pozhariskaia-ksu/Trinity/cubesat_faserns_servo2.jpg

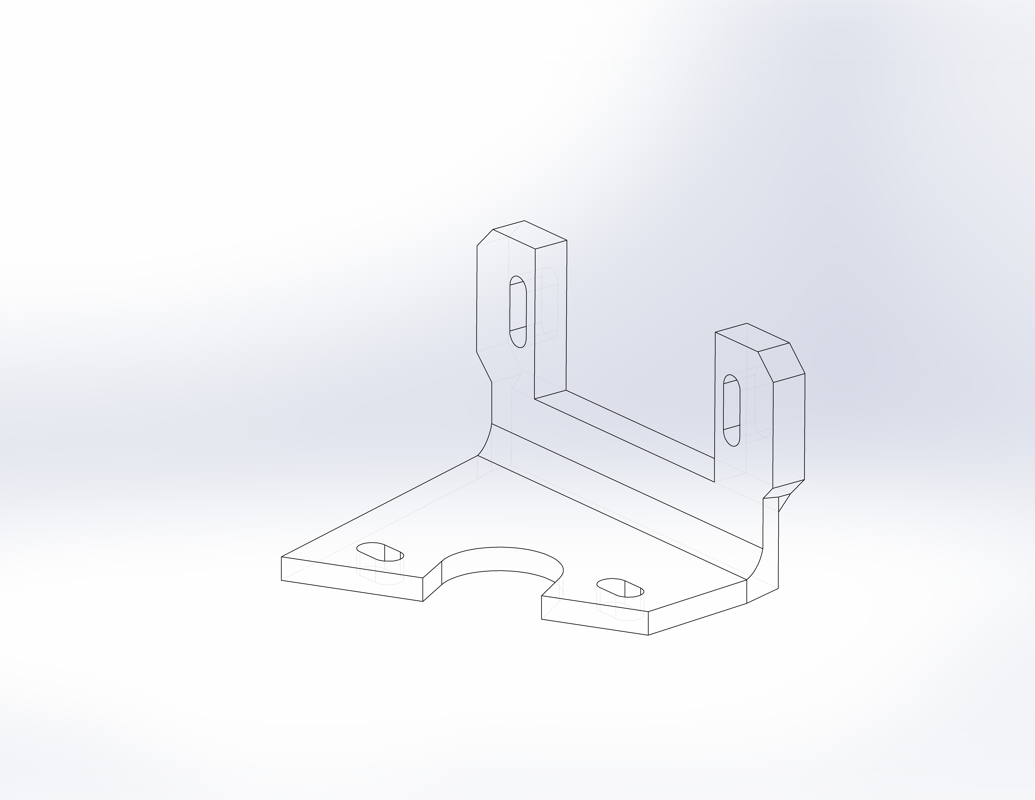
cubesat_faserns_servo2.jpg
