pozhariskaia-ksu/Trinity/Фото/IMAGE 2026-02-09 00:02:16.jpg

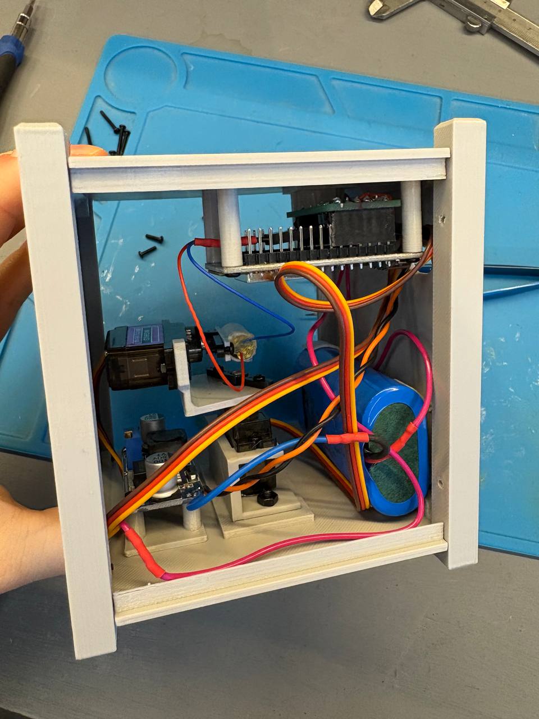
Фото/IMAGE 2026-02-09 00:02:16.jpg
