pozhariskaia-ksu/Trinity/Фото/IMAGE 2026-02-09 00:02:20.jpg

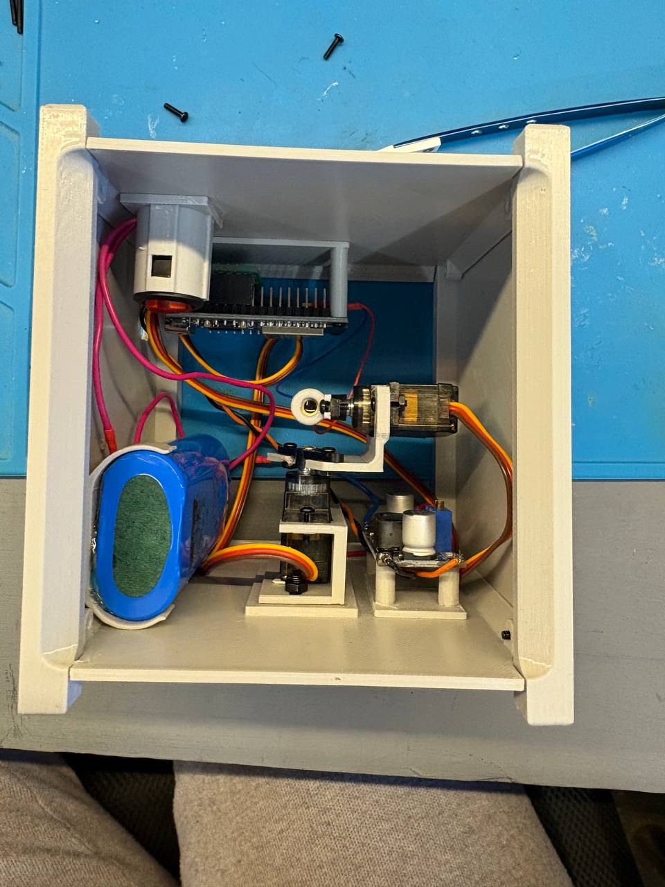
Фото/IMAGE 2026-02-09 00:02:20.jpg
