pozhariskaia-ksu/Trinity/Фото/IMAGE 2026-02-09 00:02:39.jpg

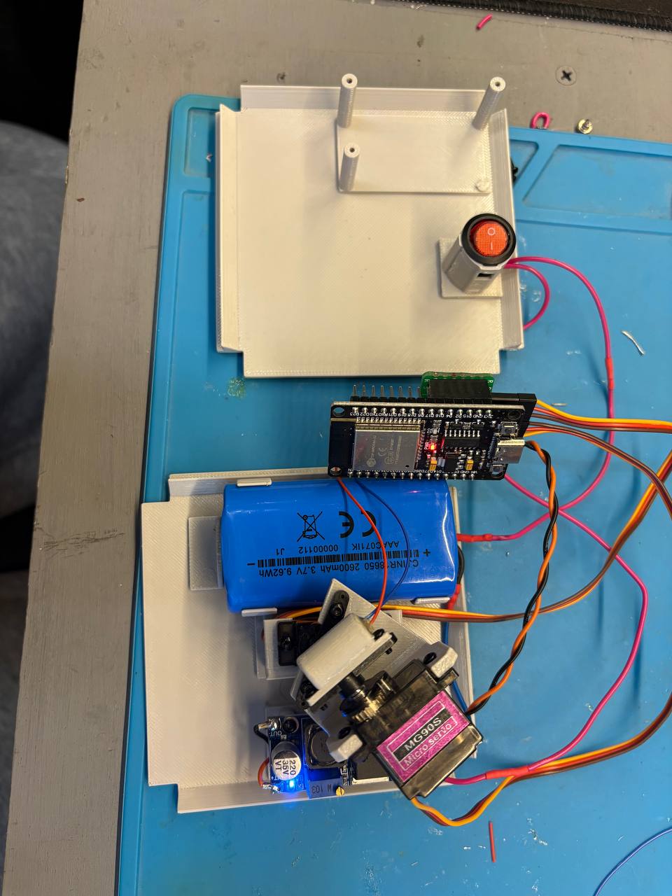
Фото/IMAGE 2026-02-09 00:02:39.jpg
