pozhariskaia-ksu/Trinity/Чертежи/1000079052.jpg

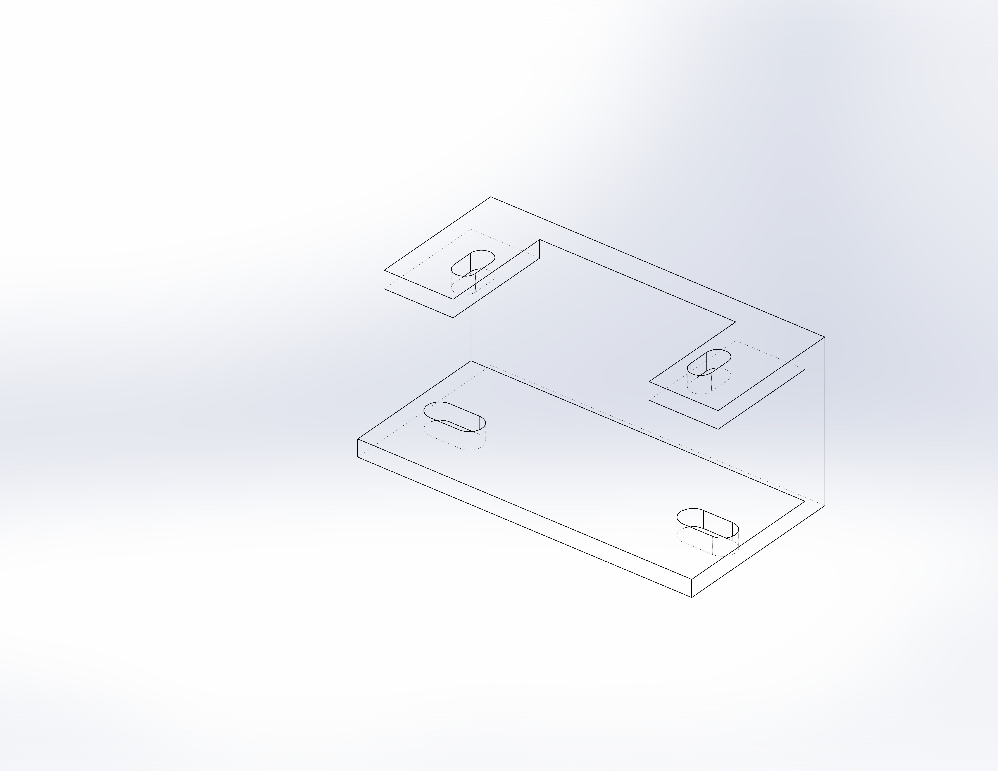
Чертежи/1000079052.jpg
