pozhariskaia-ksu/Trinity/Чертежи/1000079053.jpg

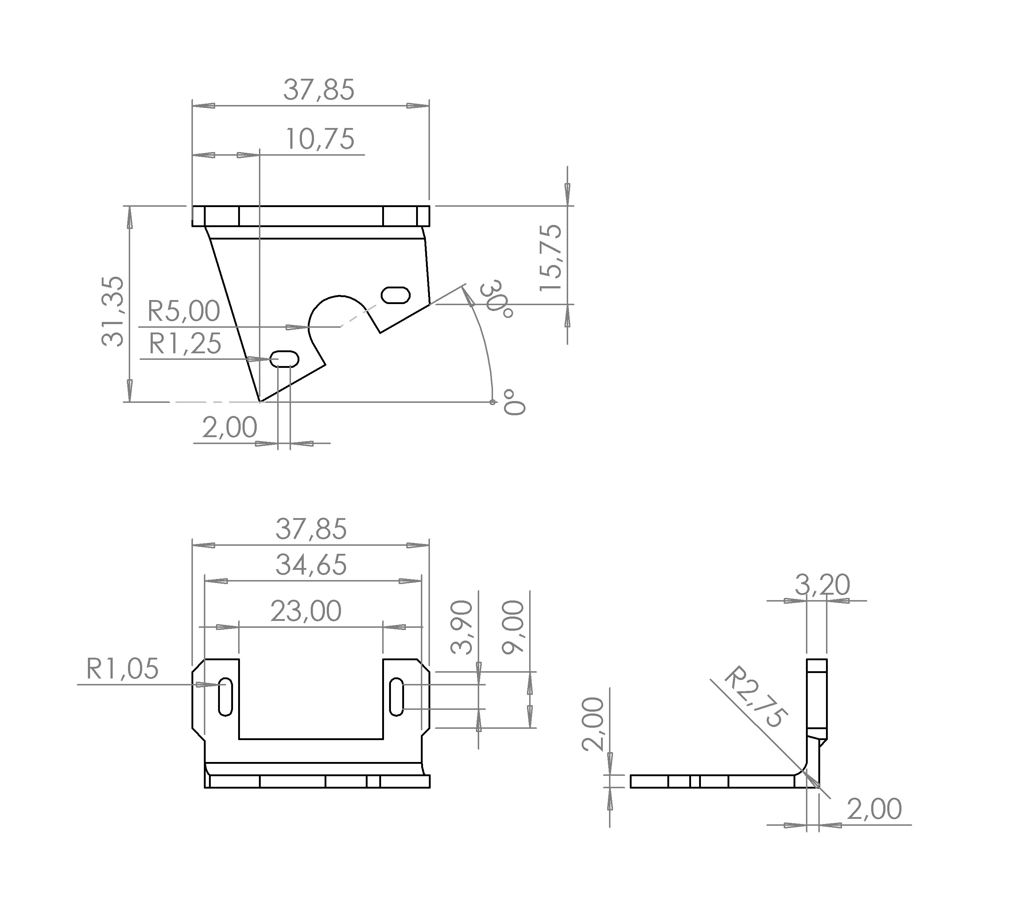
Чертежи/1000079053.jpg
