pozhariskaia-ksu/Trinity/Чертежи/1000079054.jpg

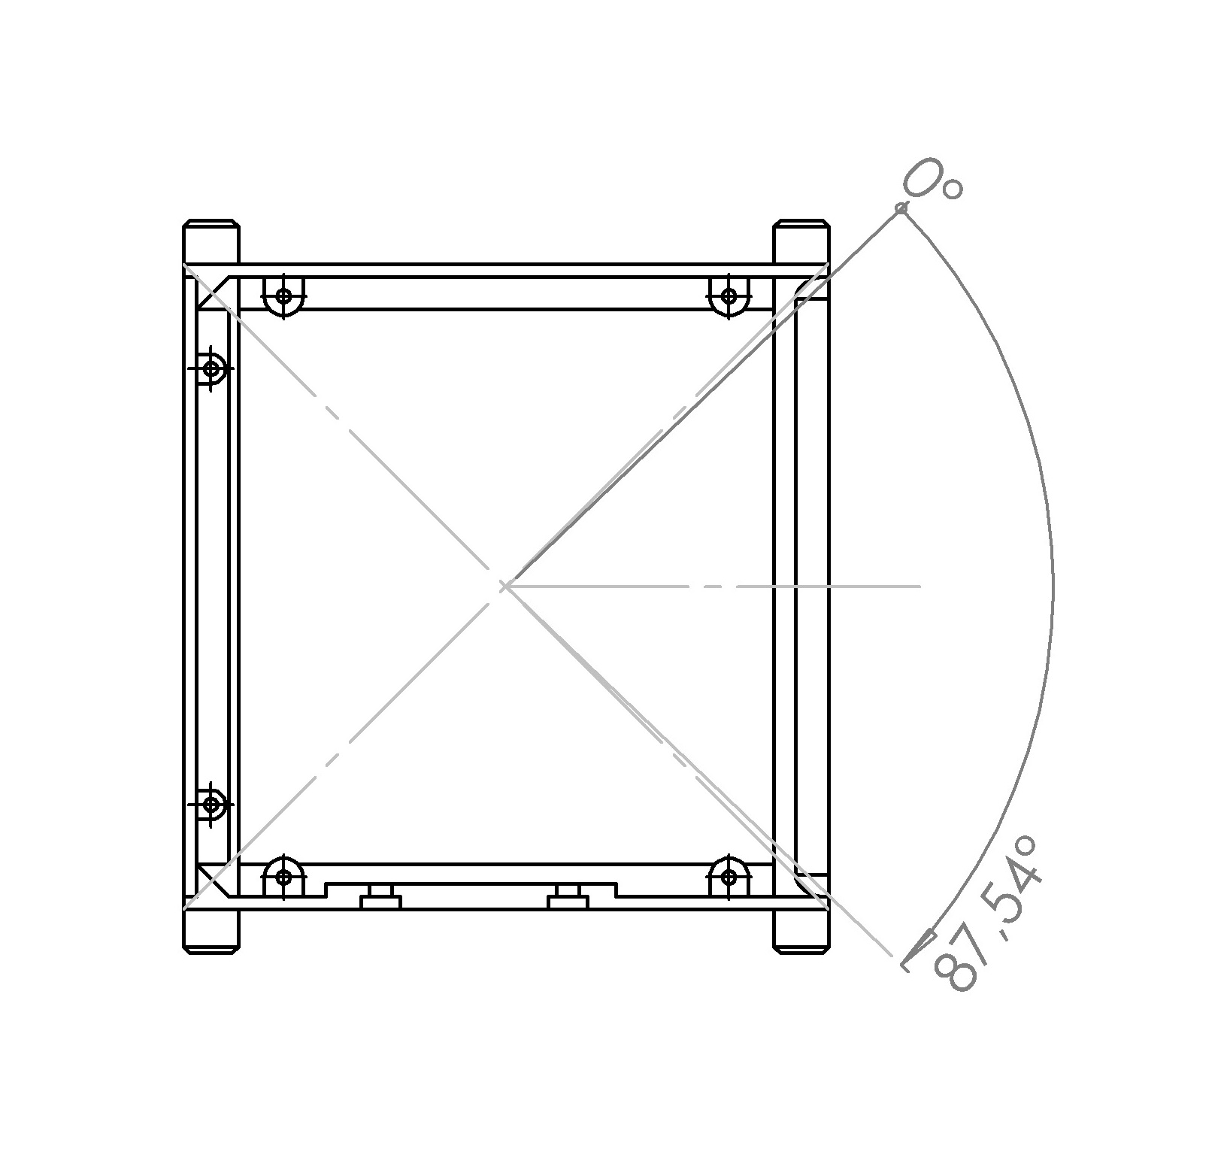
Чертежи/1000079054.jpg
