pozhariskaia-ksu/Trinity/Чертежи/1000079055.jpg

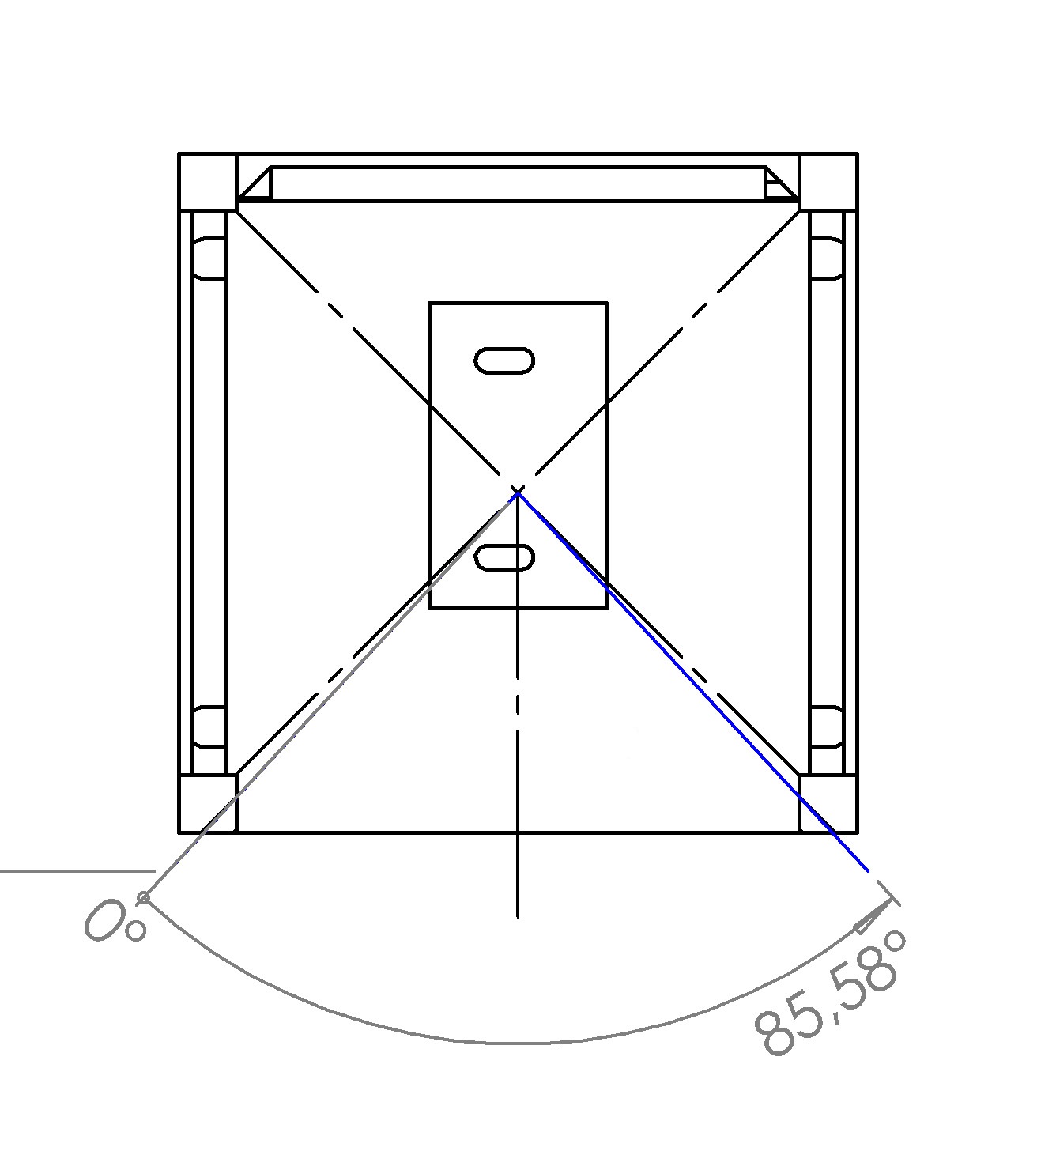
Чертежи/1000079055.jpg
