pozhariskaia-ksu/Trinity/Чертежи/1000079058.jpg

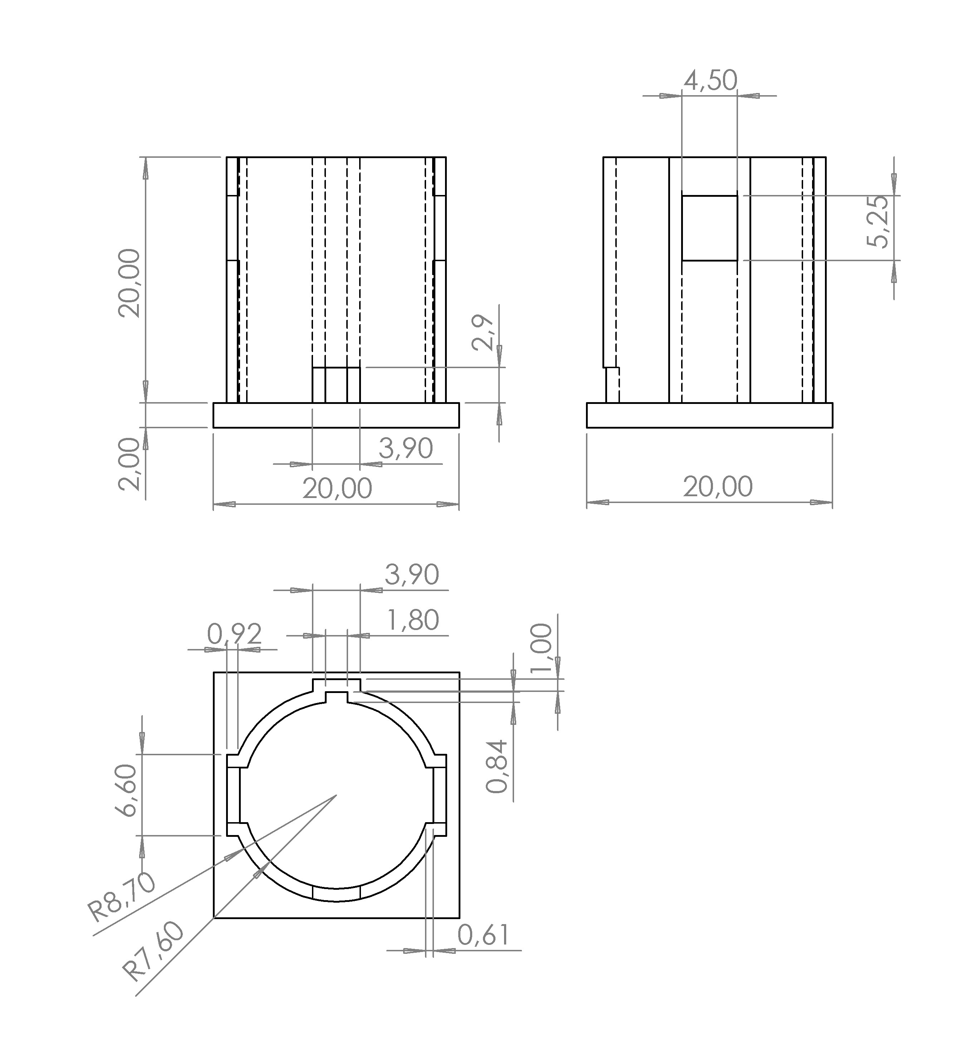
Чертежи/1000079058.jpg
