pozhariskaia-ksu/Trinity/Чертежи/1000079060.jpg

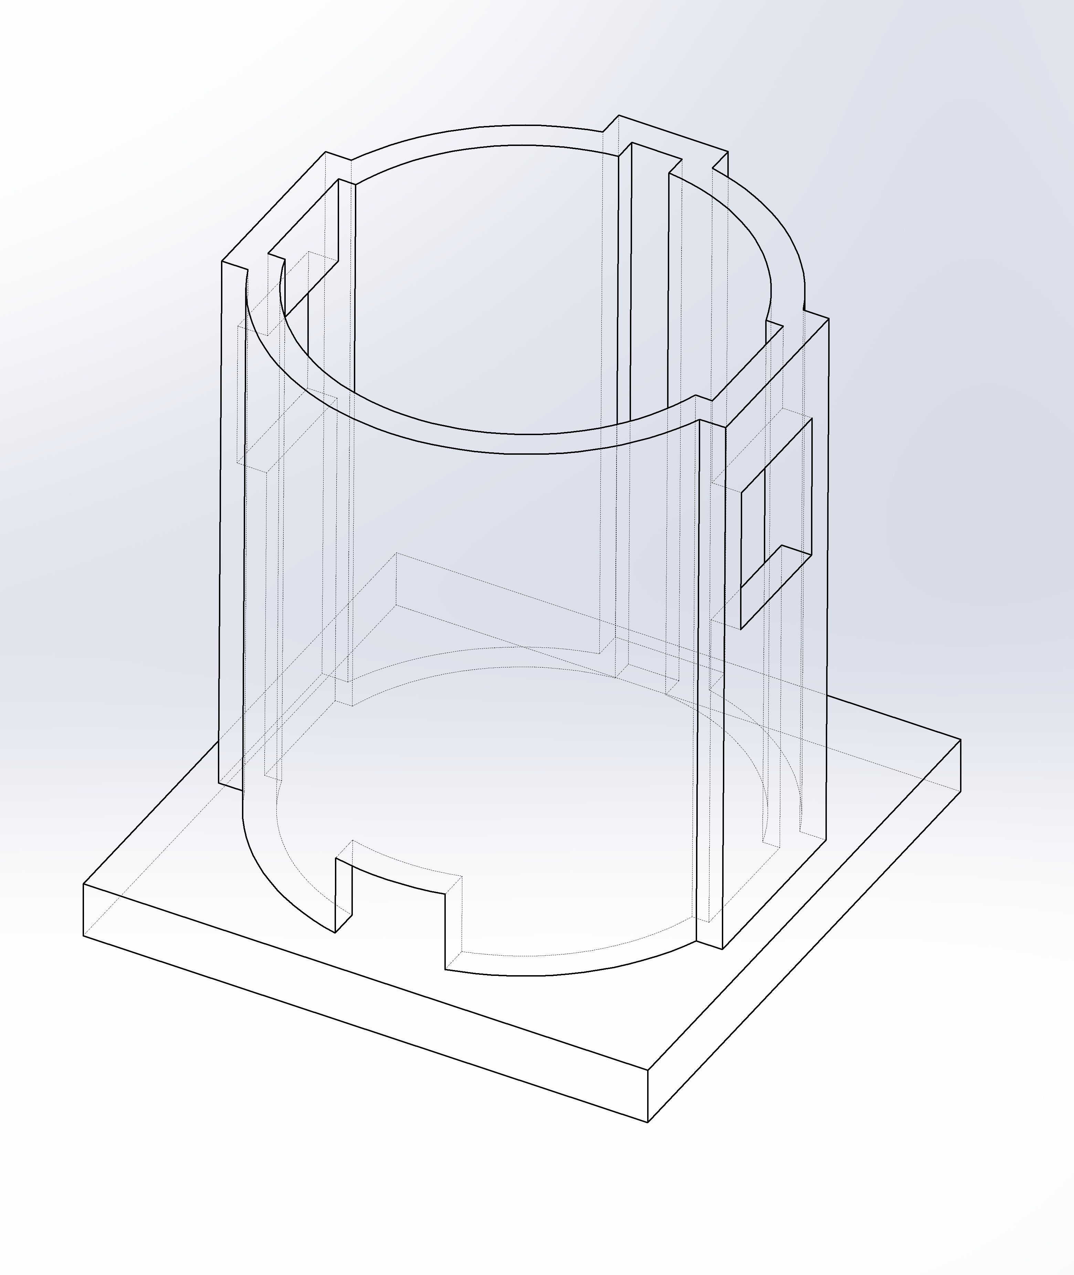
Чертежи/1000079060.jpg
