pozhariskaia-ksu/Trinity/Чертежи/cubesat_fasteners_servo.jpg

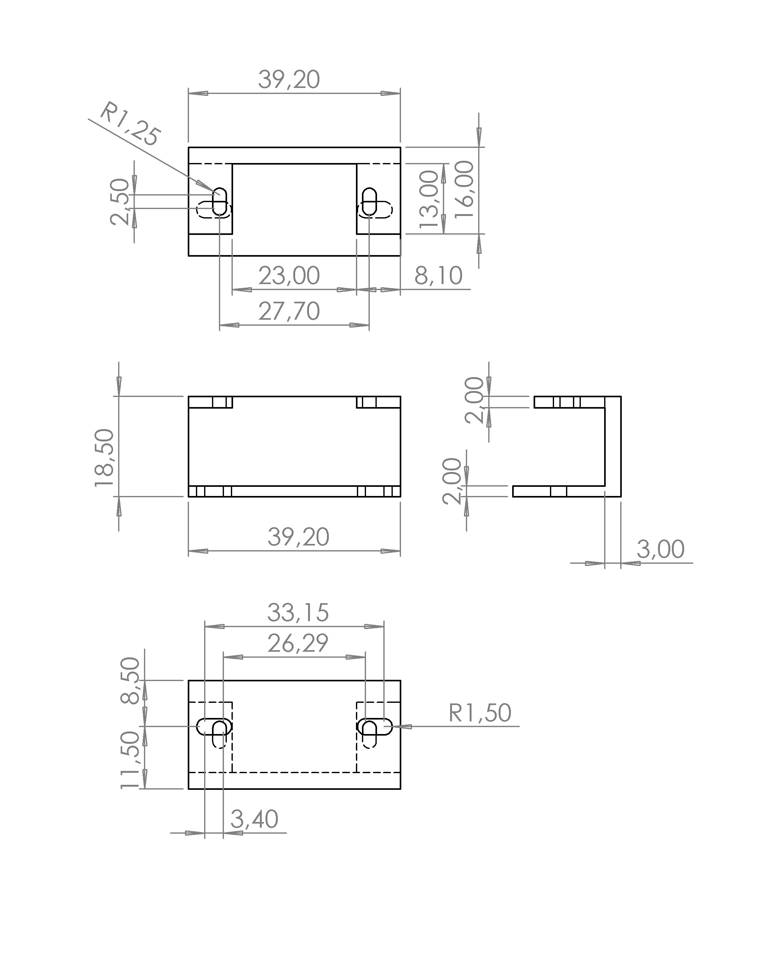
Чертежи/cubesat_fasteners_servo.jpg
