pozhariskaia-ksu/Trinity/Чертежи/В сборе.jpg

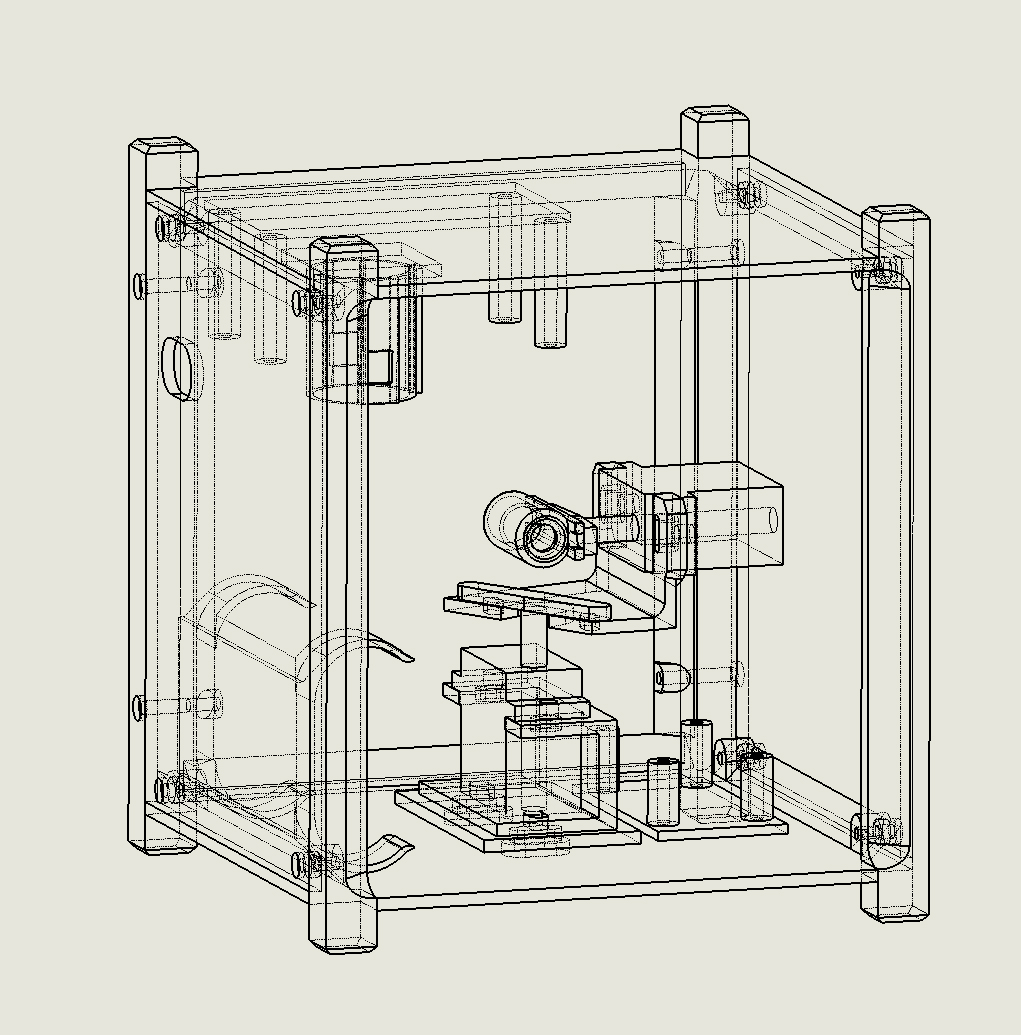
Чертежи/В сборе.jpg
