pozhariskaia-ksu/Trinity/Чертежи/Сборка корпуса 2.JPG

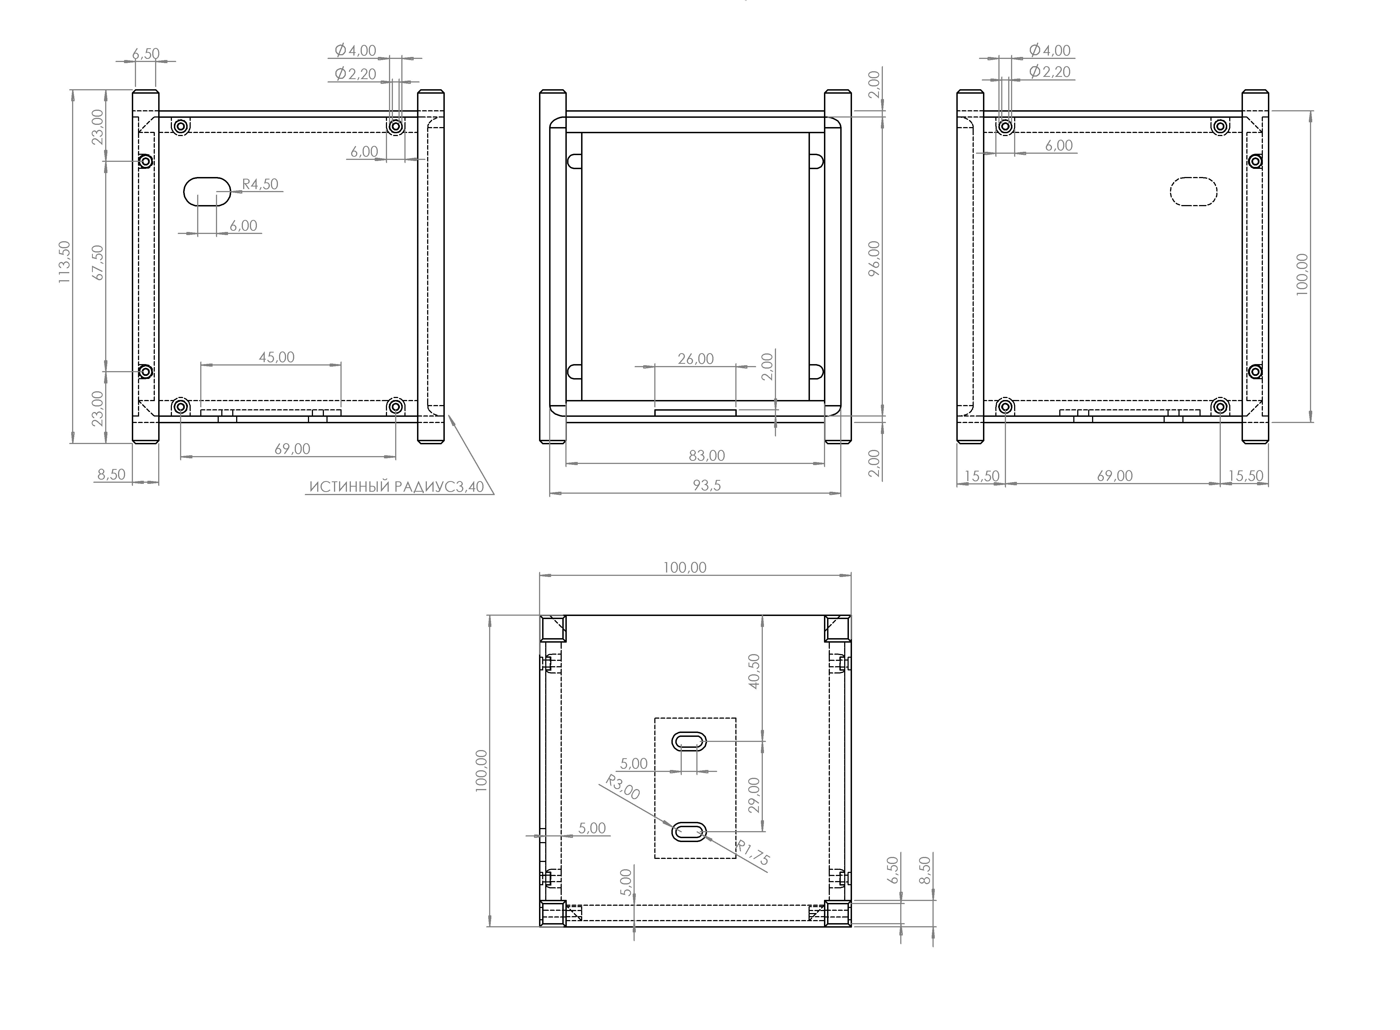
Чертежи/Сборка корпуса 2.JPG
