pozhariskaia-ksu/Trinity/3D модели/Крышка пульта.STL

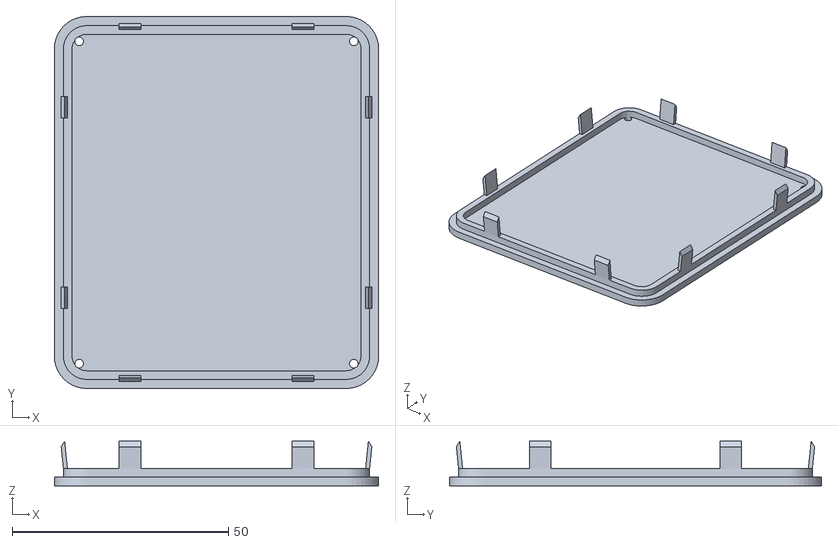
[picture p40: CAD file, 2026-02-08]
3D модели/Крышка пульта.STL
75.0 x 86.0 x 10.3
