pozhariskaia-ksu/Trinity/3D модели/??????? ??????  с отверстием.STL

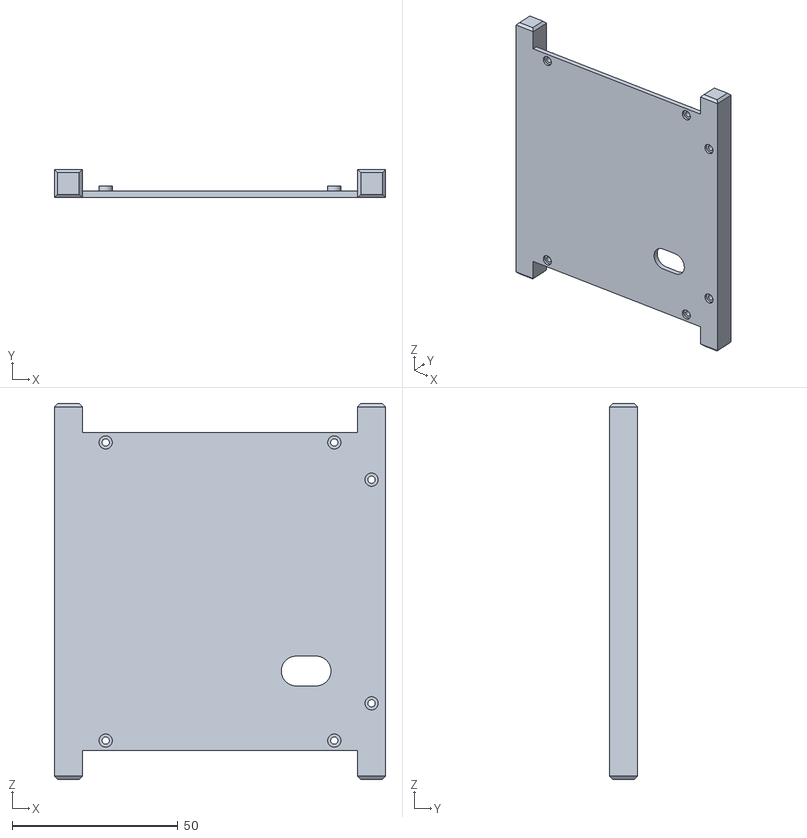
[picture p41: CAD file, 2026-02-08]
3D модели/??????? ?????? с отверстием.STL
100.0 x 8.50 x 113.5
