pozhariskaia-ksu/Trinity/3D модели/Подложка клавиатуры.STL

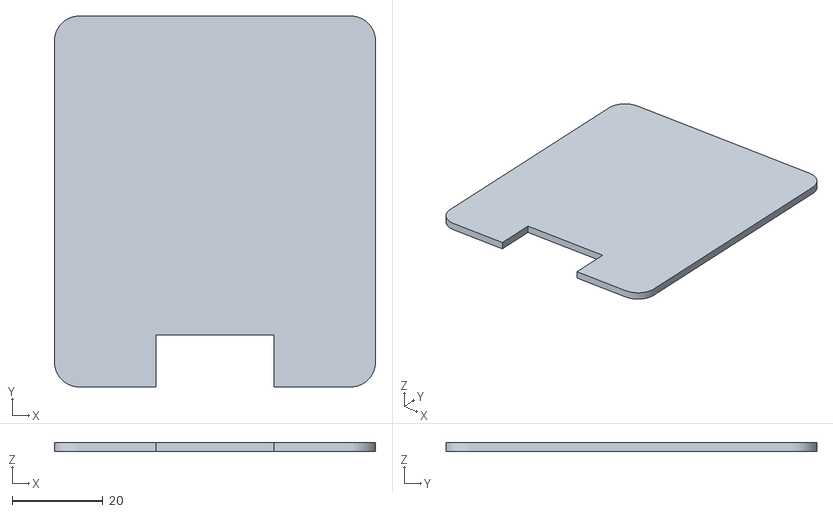
[picture p42: CAD file, 2026-02-08]
3D модели/Подложка клавиатуры.STL
70.9 x 81.9 x 2.00
