pozhariskaia-ksu/Trinity/3D модели/Контейнер 3хАА.STL

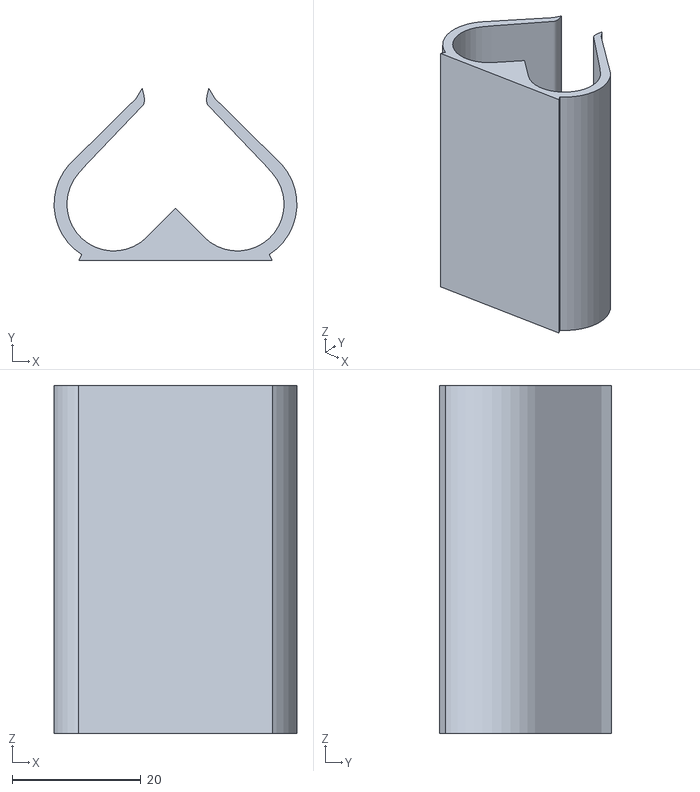
[picture p43: CAD file, 2026-02-08]
3D модели/Контейнер 3хАА.STL
37.7 x 26.7 x 54.0
