pozhariskaia-ksu/Trinity/3D модели/??????? ?????? ния крышки.STL

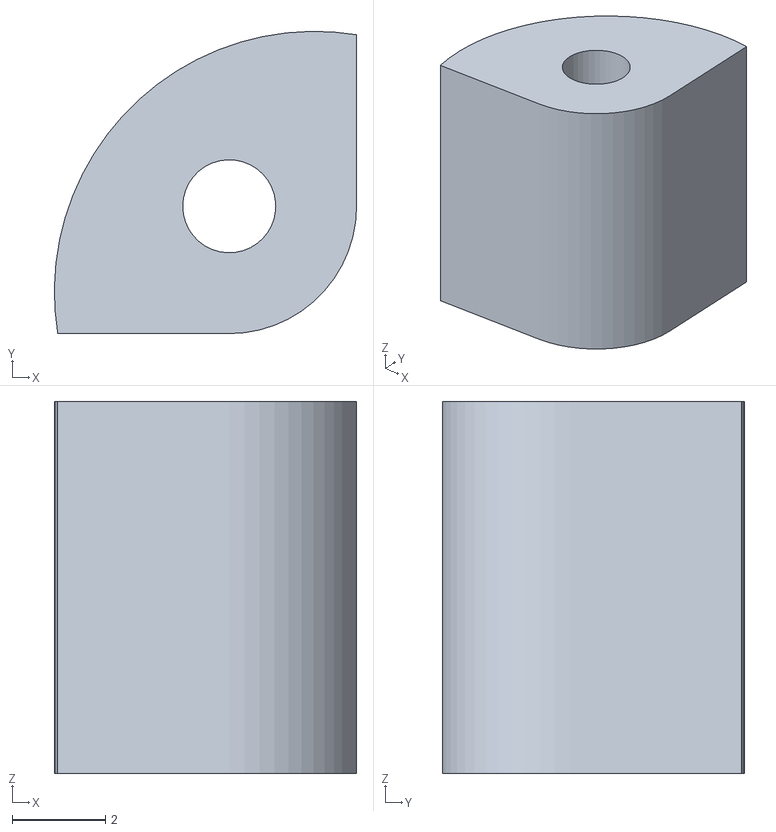
[picture p44: CAD file, 2026-02-08]
3D модели/??????? ?????? ния крышки.STL
6.50 x 6.50 x 8.00
