pozhariskaia-ksu/Trinity/3D модели/????? ????????? ей платы х3.STL

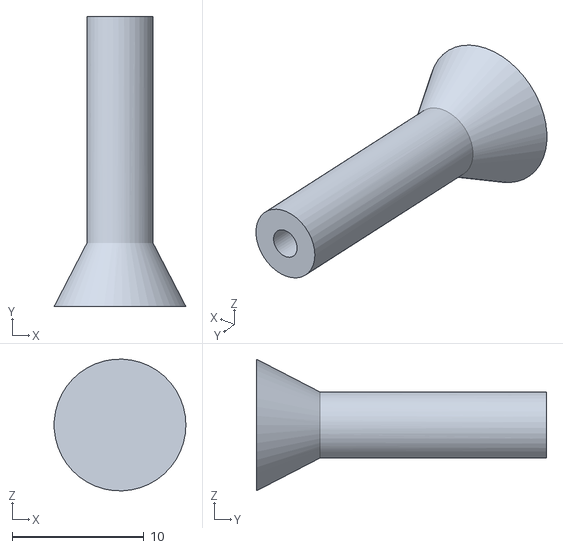
[picture p45: CAD file, 2026-02-08]
3D модели/????? ????????? ей платы х3.STL
10.0 x 22.0 x 9.99
