pozhariskaia-ksu/Trinity/3D модели/Корпус пульта деталь.STL

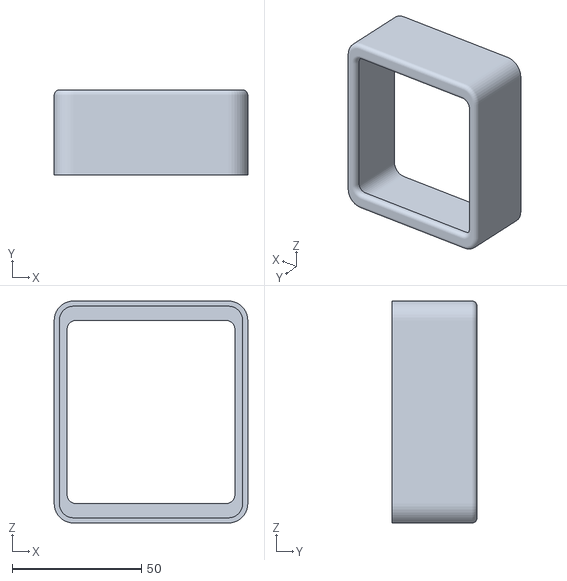
[picture p46: CAD file, 2026-02-08]
3D модели/Корпус пульта деталь.STL
75.0 x 33.0 x 86.0
