pozhariskaia-ksu/Trinity/3D модели/????????? ??? умулятора.STL

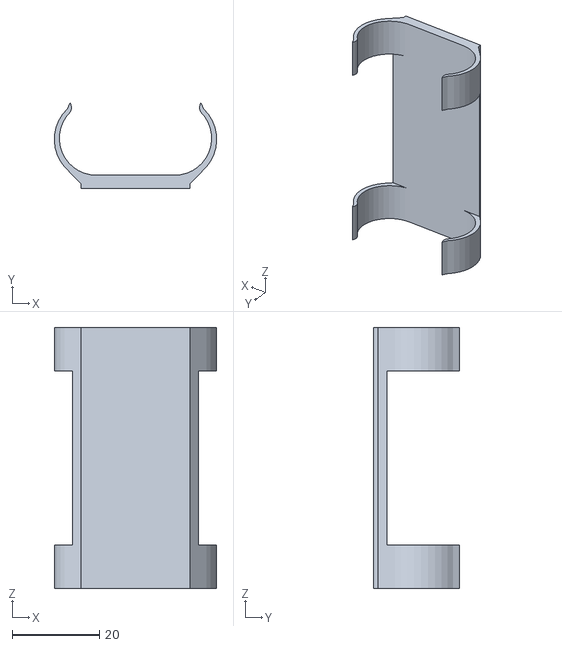
[picture p47: CAD file, 2026-02-08]
3D модели/????????? ??? умулятора.STL
37.3 x 19.7 x 60.0
