pozhariskaia-ksu/Trinity/3D модели/Верхняя деталь.STL

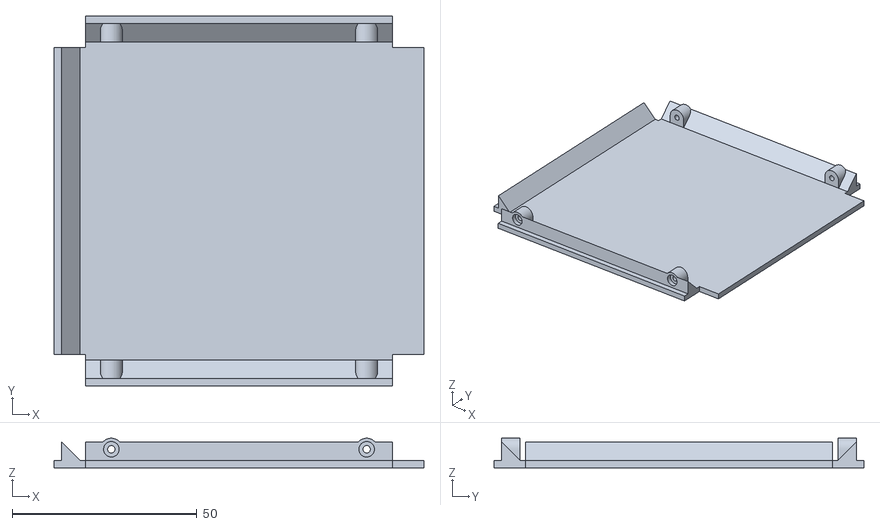
[picture p48: CAD file, 2026-02-08]
3D модели/Верхняя деталь.STL
100.0 x 100.0 x 7.99
