pozhariskaia-ksu/Trinity/3D модели/Нижняя деталь.STL

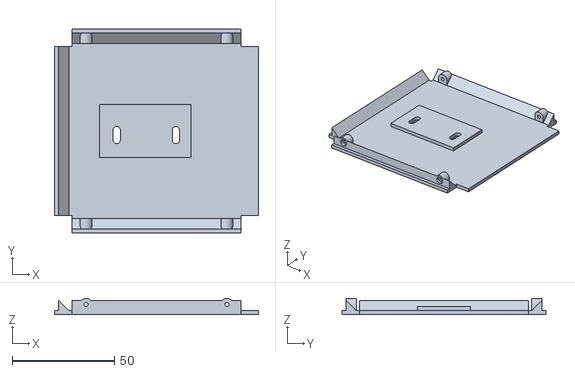
[picture p49: CAD file, 2026-02-08]
3D модели/Нижняя деталь.STL
100.0 x 100.0 x 7.99
