pozhariskaia-ksu/Trinity/3D модели/Кронштейн выключателя.STL

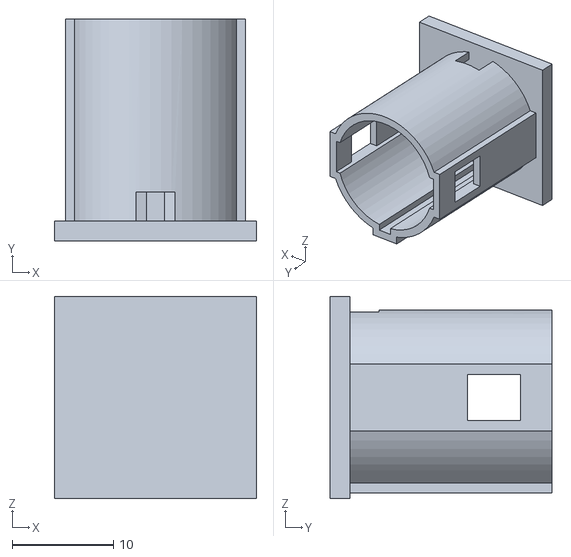
[picture p50: CAD file, 2026-02-08]
3D модели/Кронштейн выключателя.STL
20.0 x 22.0 x 20.0
