pozhariskaia-ksu/Trinity/3D модели/????????? ???????  сервопривода.STL

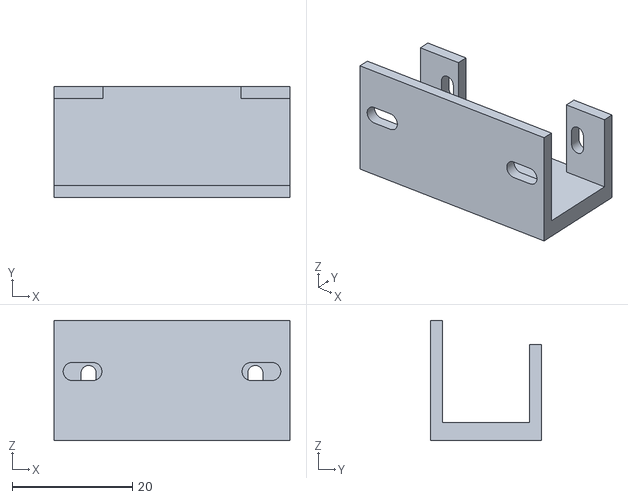
[picture p51: CAD file, 2026-02-08]
3D модели/????????? ??????? сервопривода.STL
39.2 x 18.5 x 20.0
