pozhariskaia-ksu/Trinity/3D модели/Корпус излучателя.STL

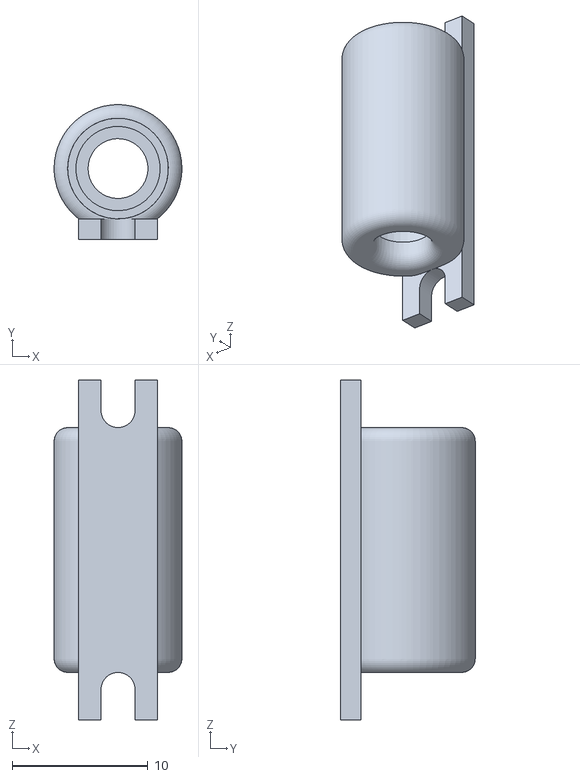
[picture p52: CAD file, 2026-02-08]
3D модели/Корпус излучателя.STL
9.40 x 9.89 x 25.0
