pozhariskaia-ksu/Trinity/3D модели/???????? ?????? яющей платы.STL

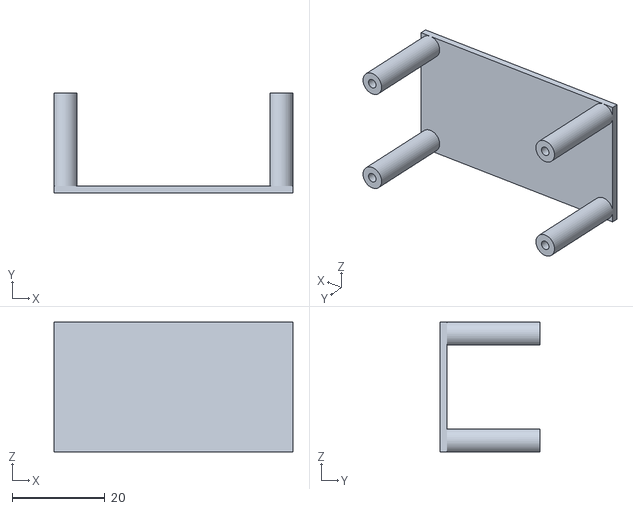
[picture p53: CAD file, 2026-02-08]
3D модели/???????? ?????? яющей платы.STL
51.5 x 21.5 x 28.0
