pozhariskaia-ksu/Trinity/3D модели/???????? ?????? ющего блока.STL

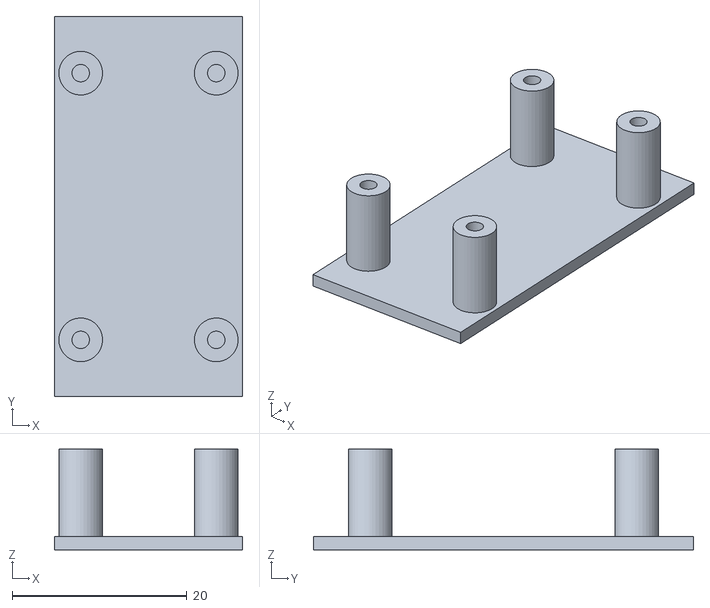
[picture p54: CAD file, 2026-02-08]
3D модели/???????? ?????? ющего блока.STL
21.5 x 43.5 x 11.5
