pozhariskaia-ksu/Trinity/3D модели/Задняя деталь.STL

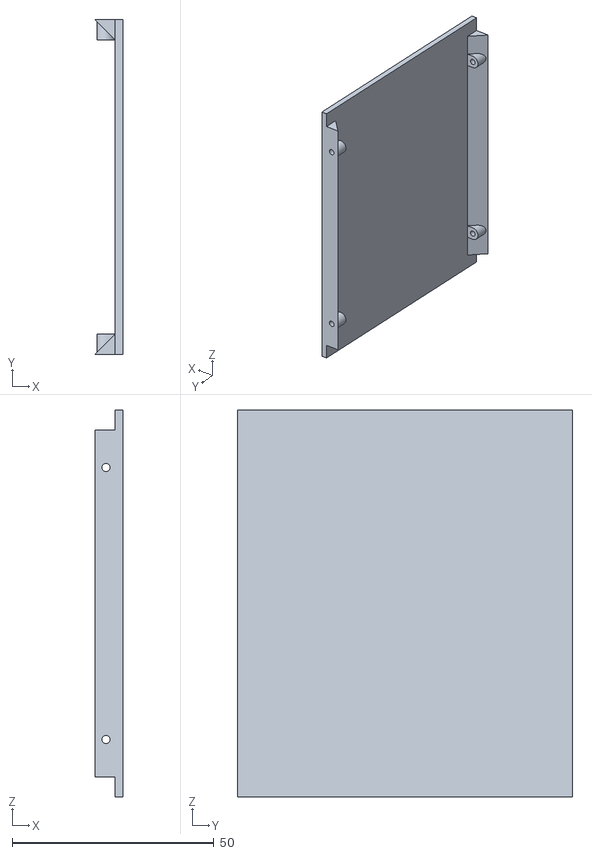
[picture p55: CAD file, 2026-02-08]
3D модели/Задняя деталь.STL
7.00 x 83.0 x 96.0
