pozhariskaia-ksu/Trinity/3D модели/Боковая деталь х2.STL

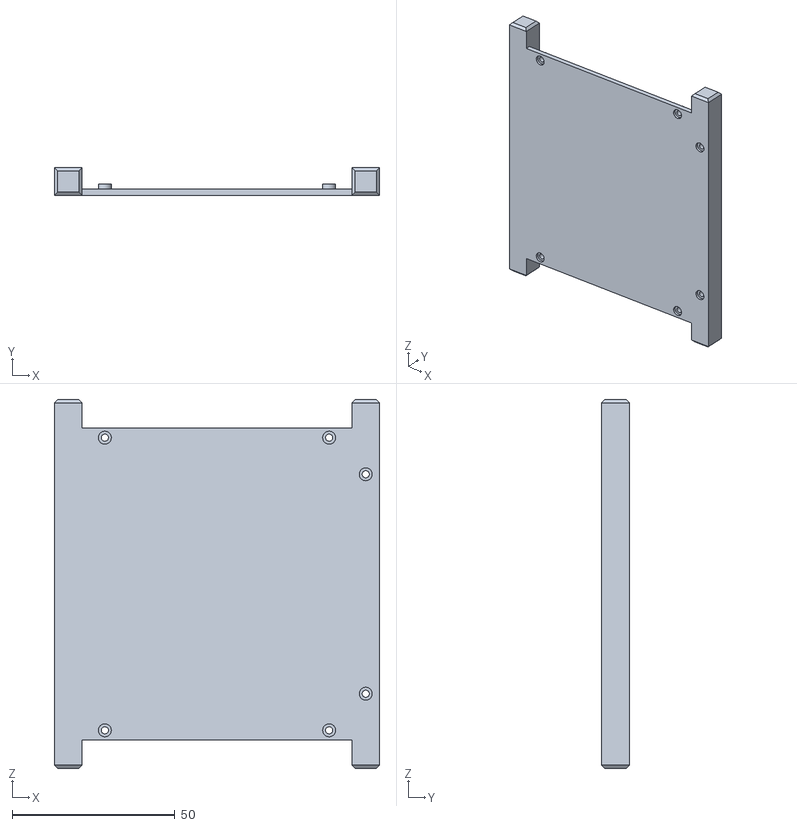
[picture p56: CAD file, 2026-02-08]
3D модели/Боковая деталь х2.STL
100.0 x 8.50 x 113.5
