pozhariskaia-ksu/Trinity/3D модели/????????? ??????? о сервопривода.STL

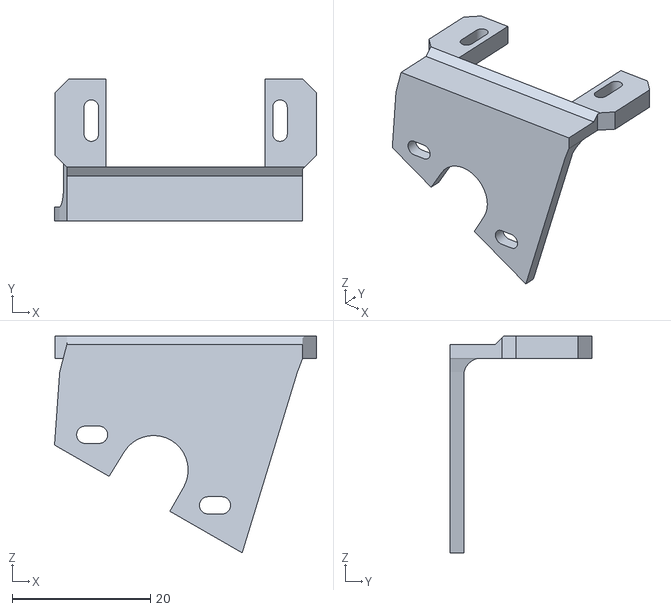
[picture p57: CAD file, 2026-02-08]
3D модели/????????? ??????? о сервопривода.STL
37.9 x 20.5 x 31.3
