pozhariskaia-ksu/Trinity/Чертежи/cubesat_assembly.jpg

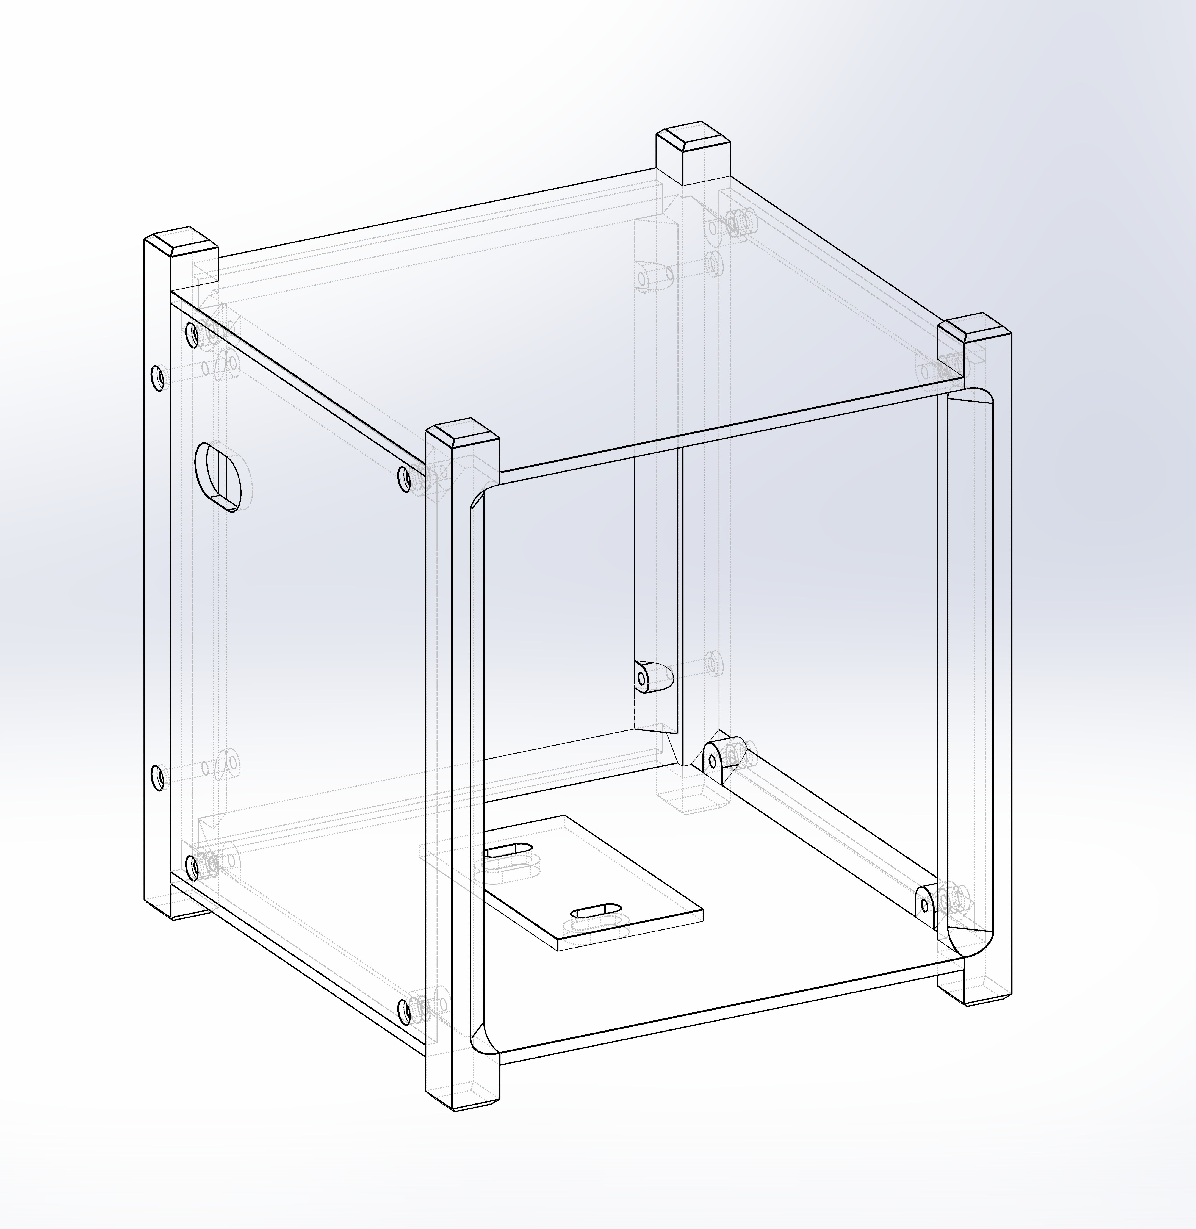
Чертежи/cubesat_assembly.jpg
