pozhariskaia-ksu/Trinity/(commit log)

2026-02-08 Программный код
2026-02-08 3D модели
    [???????? ?????? ющего блока.STL, ???????? ?????? яющей платы.STL, ????????? ??? умулятора.STL, ????????? ??????? сервопривода.STL, ????????? ??????? о сервопривода.STL, Боковая деталь х2.STL, Верхняя деталь.STL, Задняя деталь.STL]
2026-02-09 бумажная часть
